MrArmonius/ElecBoard/README.md

# ElecBoard
A DIY electric board
Read the pdf file "ElecBoard description.pdf"
