MrArmonius/ElecBoard/Fusion360/cache batterie en dessous.PNG

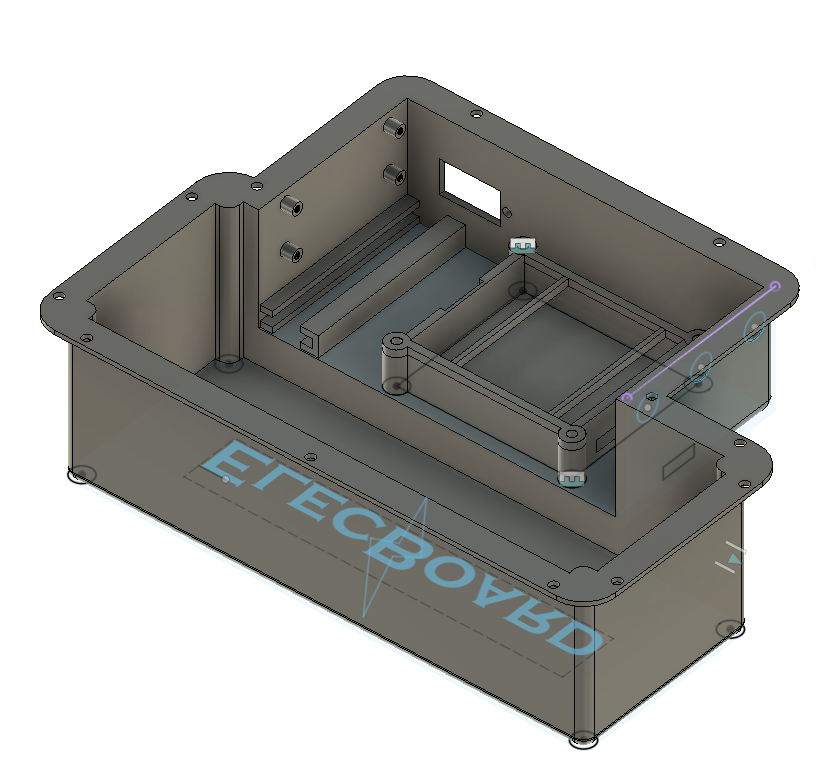
Fusion360/cache batterie en dessous.PNG
