MrArmonius/ElecBoard/Fusion360/Cache batterie.PNG

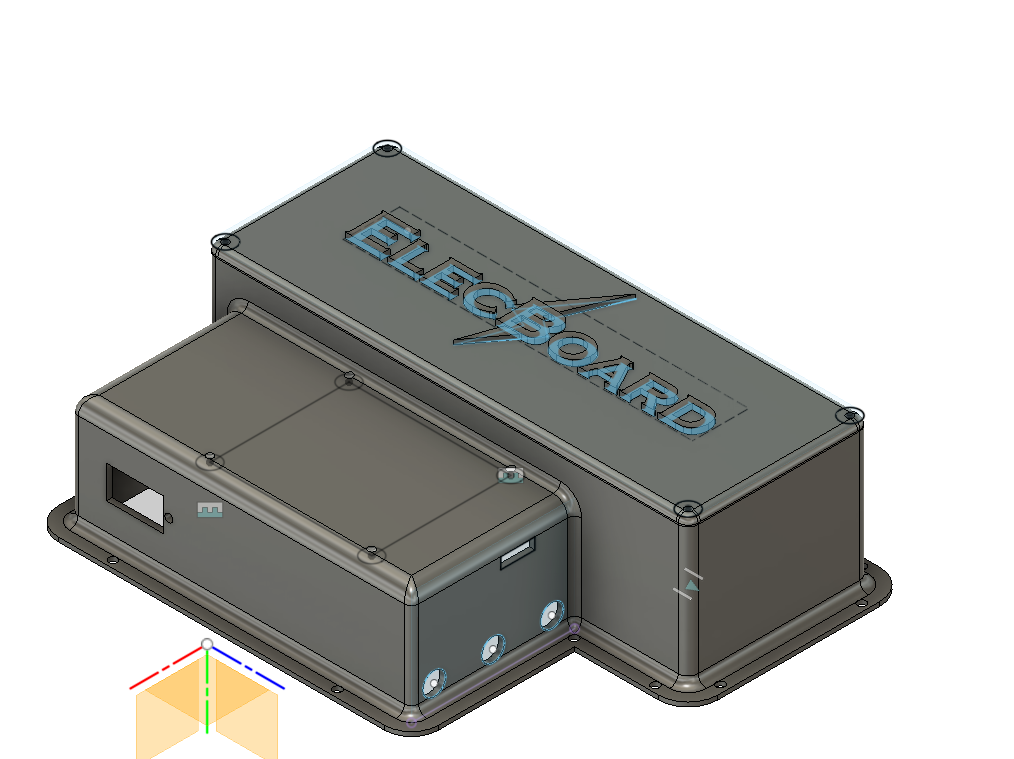
Fusion360/Cache batterie.PNG
