MrArmonius/ElecBoard/Fusion360/ESC base.stl

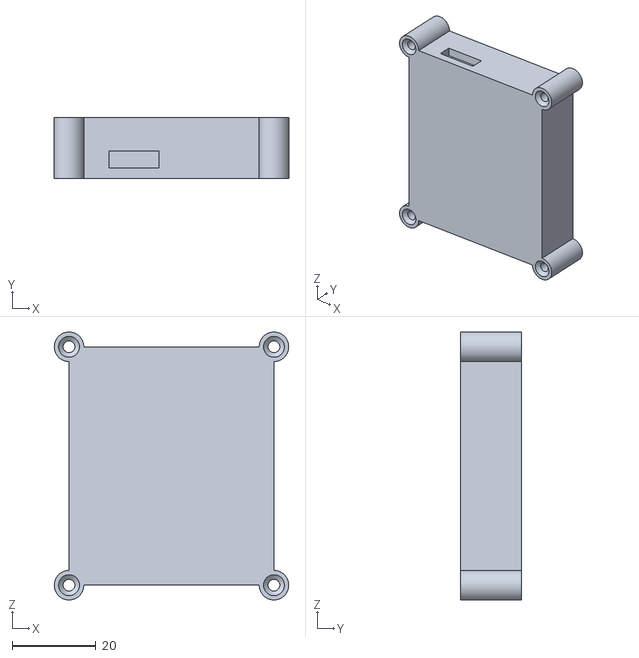
[picture p4: CAD file, 2020-06-05]
Fusion360/ESC base.stl
56.1 x 14.5 x 64.1
