MrArmonius/ElecBoard/Openscad/premier v5_trous_piece_unique.stl

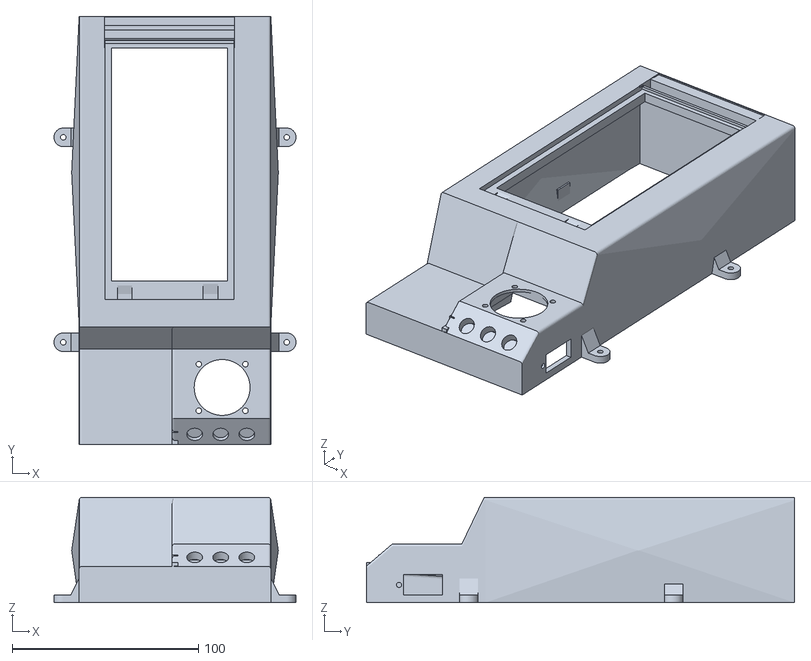
[picture p5: CAD file, 2019-03-30]
Openscad/premier v5_trous_piece_unique.stl
129.9 x 230.0 x 56.5
