MrArmonius/ElecBoard/Openscad/premier v5_trous_piece_deux.stl

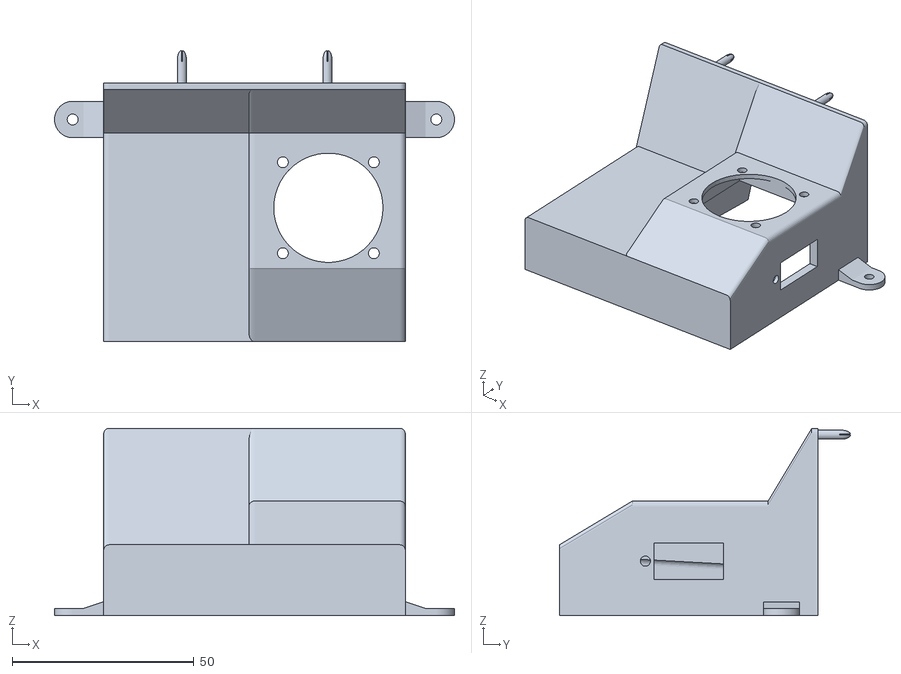
[picture p6: CAD file, 2019-03-30]
Openscad/premier v5_trous_piece_deux.stl
109.9 x 80.0 x 51.5
