MrArmonius/ElecBoard/Fusion360/couvercle.stl

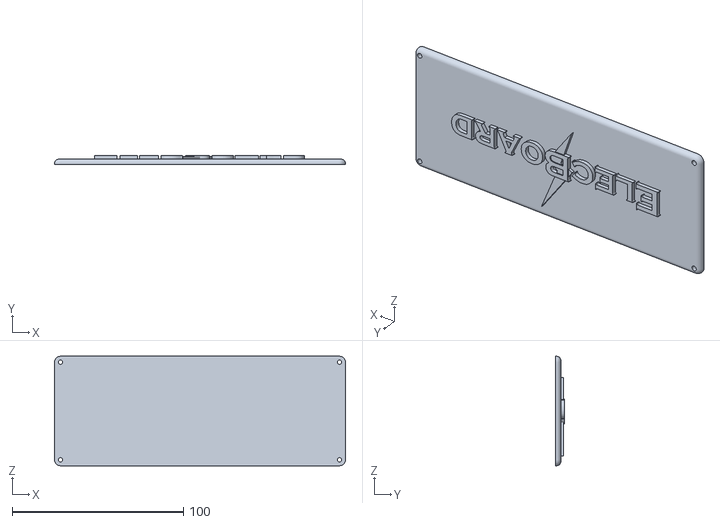
[picture p7: CAD file, 2020-06-05]
Fusion360/couvercle.stl
170.0 x 5.00 x 64.0
