MrArmonius/ElecBoard/Fusion360/soutiient esc hobbyking.stl

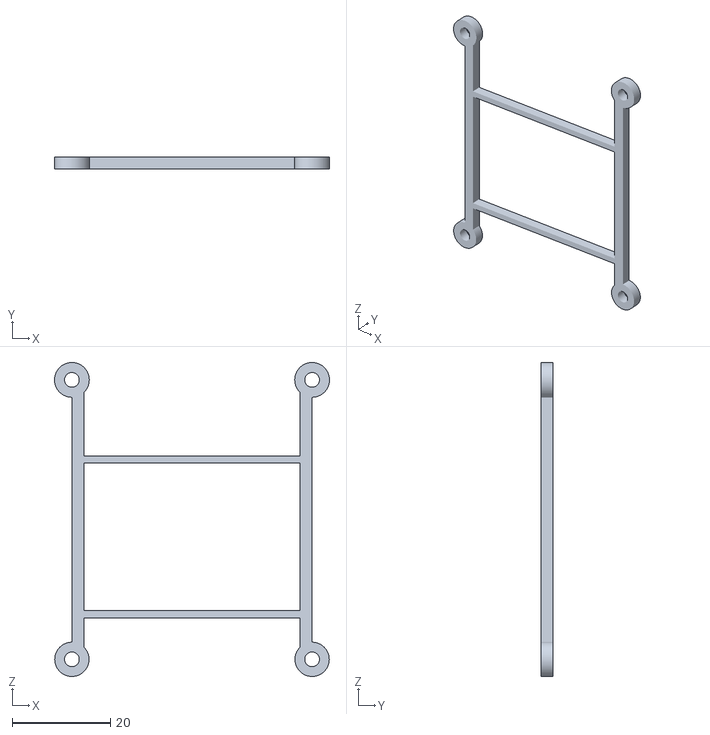
[picture p8: CAD file, 2020-06-05]
Fusion360/soutiient esc hobbyking.stl
56.1 x 2.50 x 64.0
