MrArmonius/ElecBoard/Openscad/premier v5_trous_cache_batt.stl

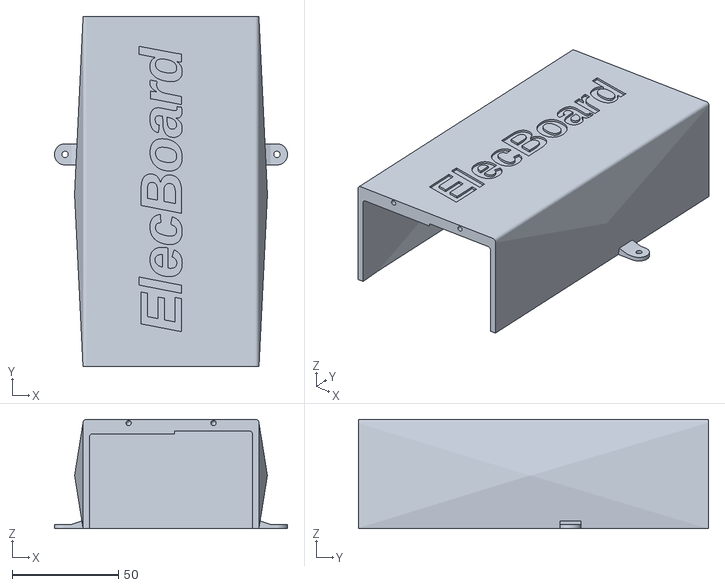
[picture p9: CAD file, 2019-03-30]
Openscad/premier v5_trous_cache_batt.stl
109.9 x 165.0 x 51.5
