MrArmonius/ElecBoard/Openscad/attache_piece.stl

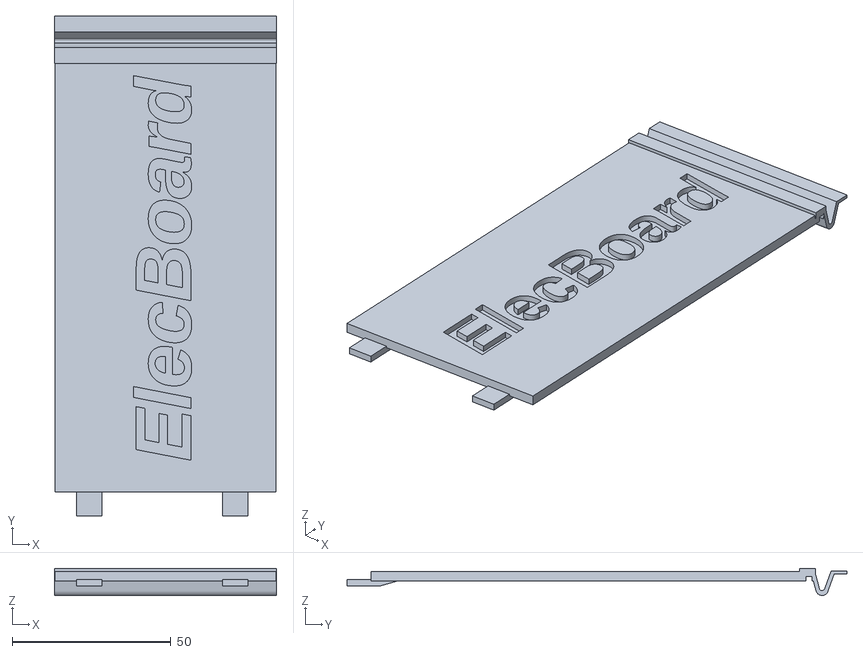
[picture p10: CAD file, 2019-03-30]
Openscad/attache_piece.stl
70.0 x 157.4 x 8.54
