MrArmonius/ElecBoard/Openscad/premier v5_trous_entier.stl

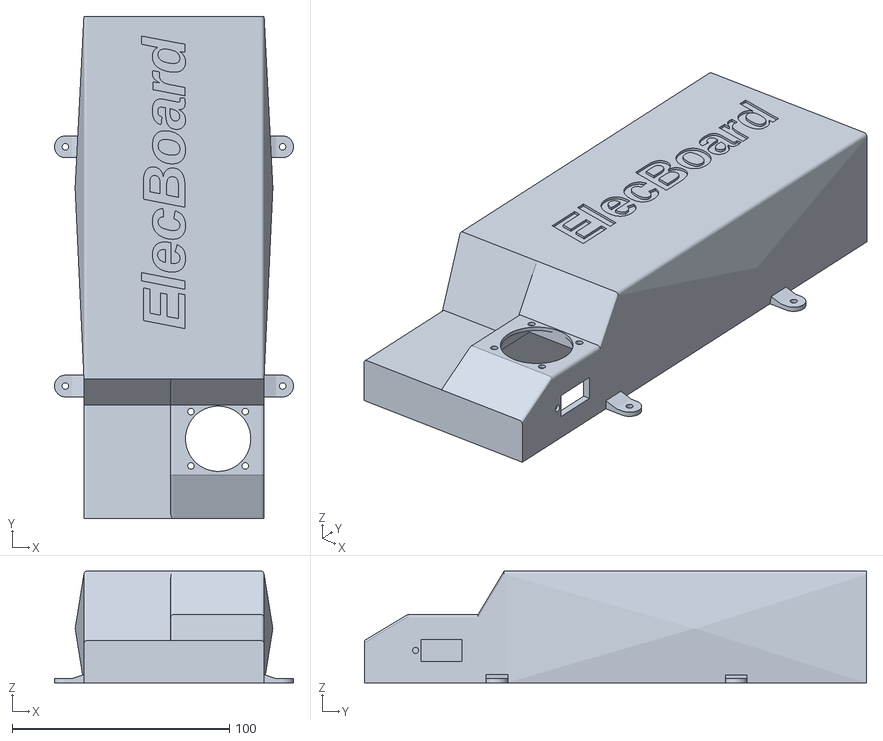
[picture p11: CAD file, 2019-03-30]
Openscad/premier v5_trous_entier.stl
109.9 x 231.0 x 51.5
