MrArmonius/ElecBoard/Openscad/cache_batt.stl

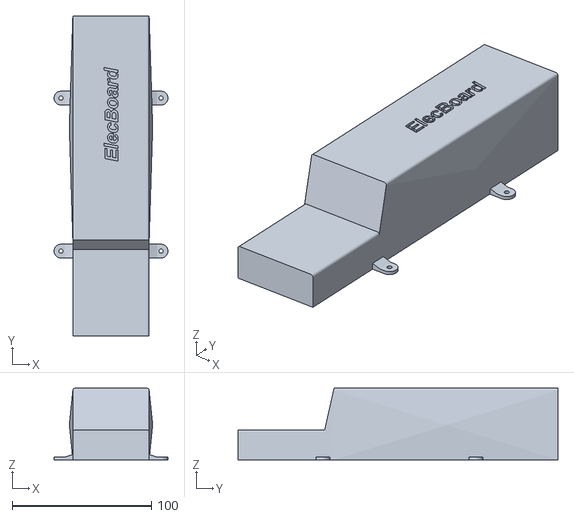
[picture p12: CAD file, 2019-03-30]
Openscad/cache_batt.stl
81.9 x 230.0 x 51.5
