MrArmonius/ElecBoard/Openscad/attache_double_vis.stl

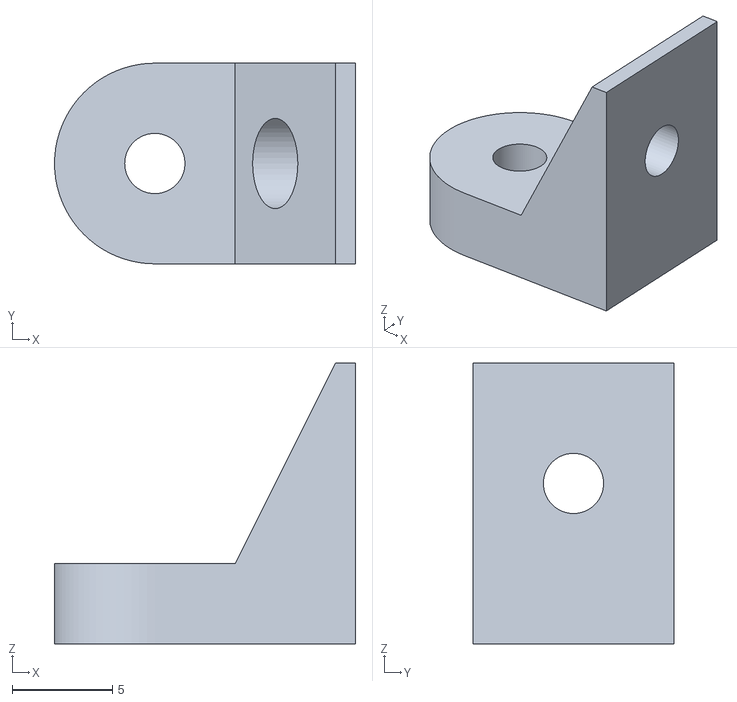
[picture p13: CAD file, 2019-03-30]
Openscad/attache_double_vis.stl
15.0 x 10.0 x 14.0
