MrArmonius/ElecBoard/Openscad/packBatt_demi.stl

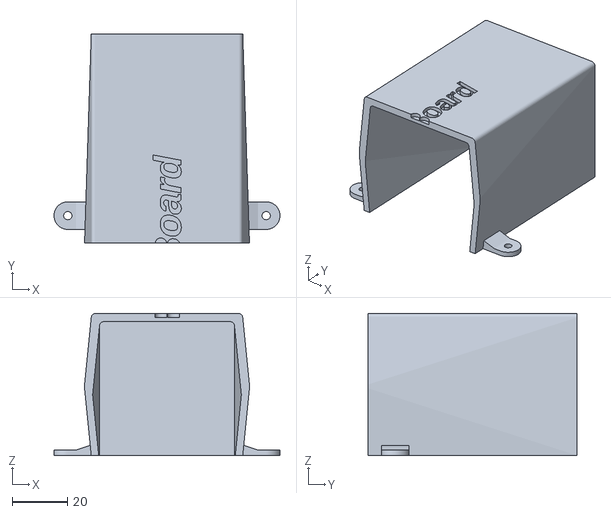
[picture p14: CAD file, 2019-03-30]
Openscad/packBatt_demi.stl
81.9 x 75.9 x 51.5
