MrArmonius/ElecBoard/Openscad/CableHolder_FIX.STL

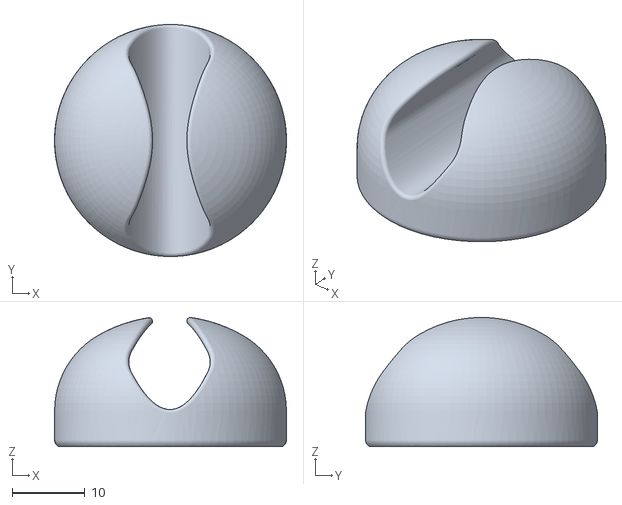
[picture p15: CAD file, 2019-03-30]
Openscad/CableHolder_FIX.STL
32.0 x 32.0 x 17.8
