MrArmonius/ElecBoard/Openscad/premier v5_trous.stl

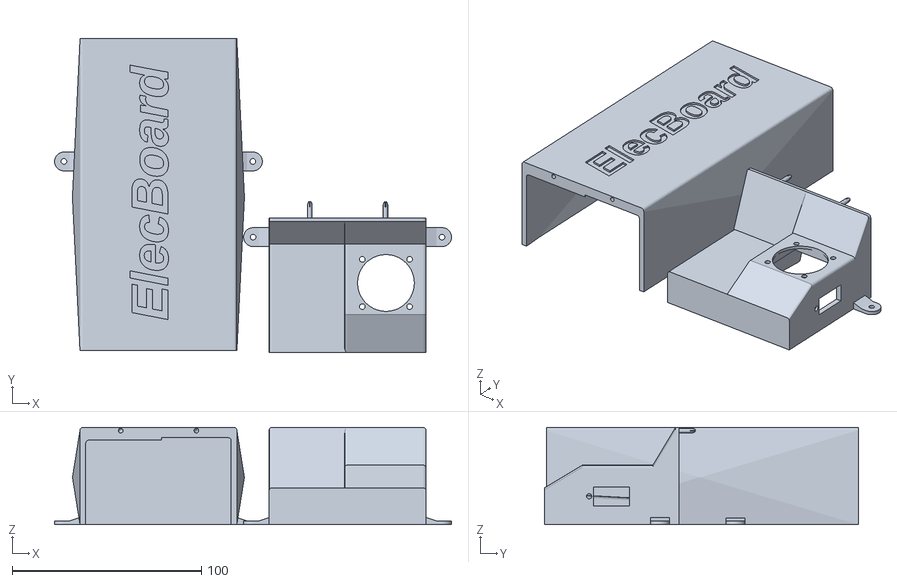
[picture p16: CAD file, 2019-03-30]
Openscad/premier v5_trous.stl
209.9 x 166.0 x 51.5
