MrArmonius/ElecBoard/Openscad/packBatt_frag.stl

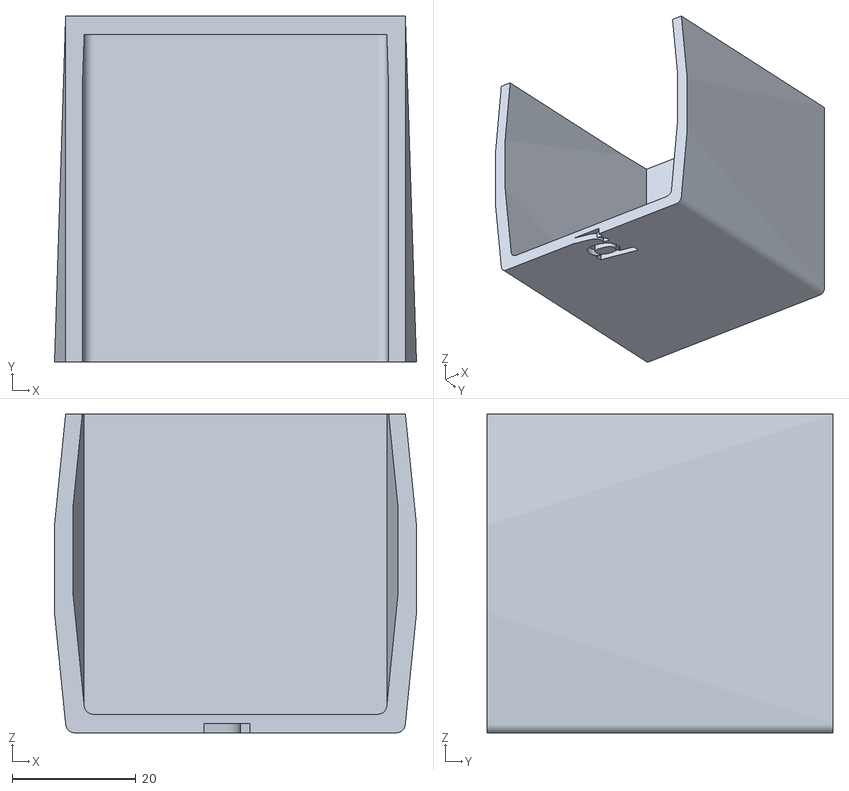
[picture p17: CAD file, 2019-03-30]
Openscad/packBatt_frag.stl
58.5 x 55.9 x 51.5
