MrArmonius/ElecBoard/Openscad/attache.stl

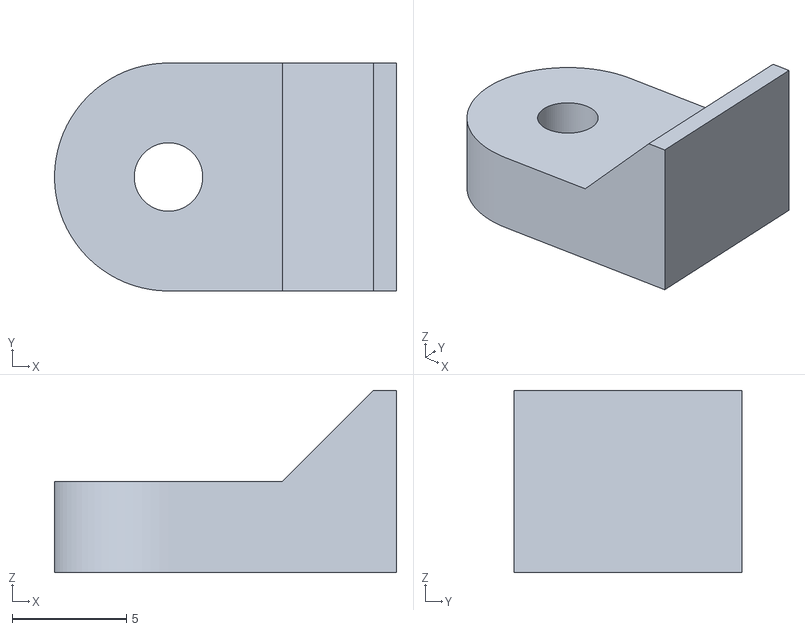
[picture p18: CAD file, 2019-03-30]
Openscad/attache.stl
15.0 x 10.0 x 8.00
