MrArmonius/ElecBoard/Openscad/cache_batt_renverse.stl

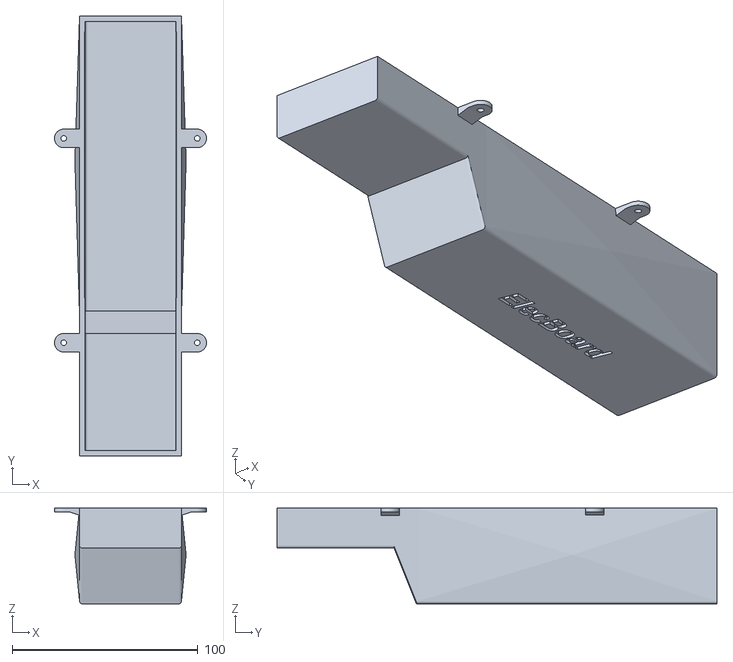
[picture p19: CAD file, 2019-03-30]
Openscad/cache_batt_renverse.stl
81.9 x 236.9 x 51.5
