MrArmonius/ElecBoard/Openscad/packBatt.stl

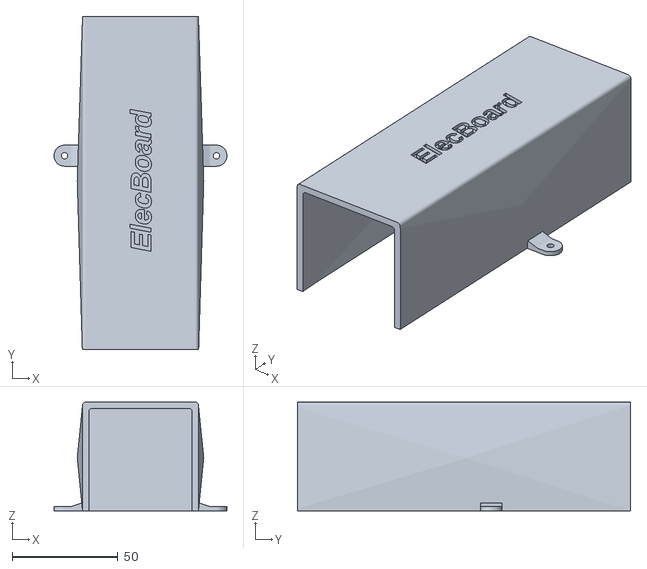
[picture p20: CAD file, 2019-03-30]
Openscad/packBatt.stl
81.9 x 157.7 x 51.5
