MrArmonius/ElecBoard/(list of files, cad)

Other CAD files:
Fusion360/Cache esc hobbyking v23.dwg
Openscad/premier v5_trous_piece_unique_last.stl
Openscad/premier v5_trous.scad
Openscad/premier v2.scad
Openscad/premier v3.scad
