MrArmonius/ElecBoard/(commit log)

2019-01-15 changement variation vitesse, changement valeur maximum de seekbar,
2019-03-30 Openscad, modele 3D
    [CableHolder_FIX.STL, Untitled.scad, attache.stl, attache_double_vis.scad, attache_double_vis.stl, attache_piece.stl, cache_batt.stl, cache_batt_renverse.stl]
2020-06-05 Init Commit
    [Cache esc hobbyking v23.dwg, ESC base.stl, couvercle.stl, soutiient esc hobbyking.stl]
